schlae/tiny-turbo-286/TinyTurbo286Sch.pdf

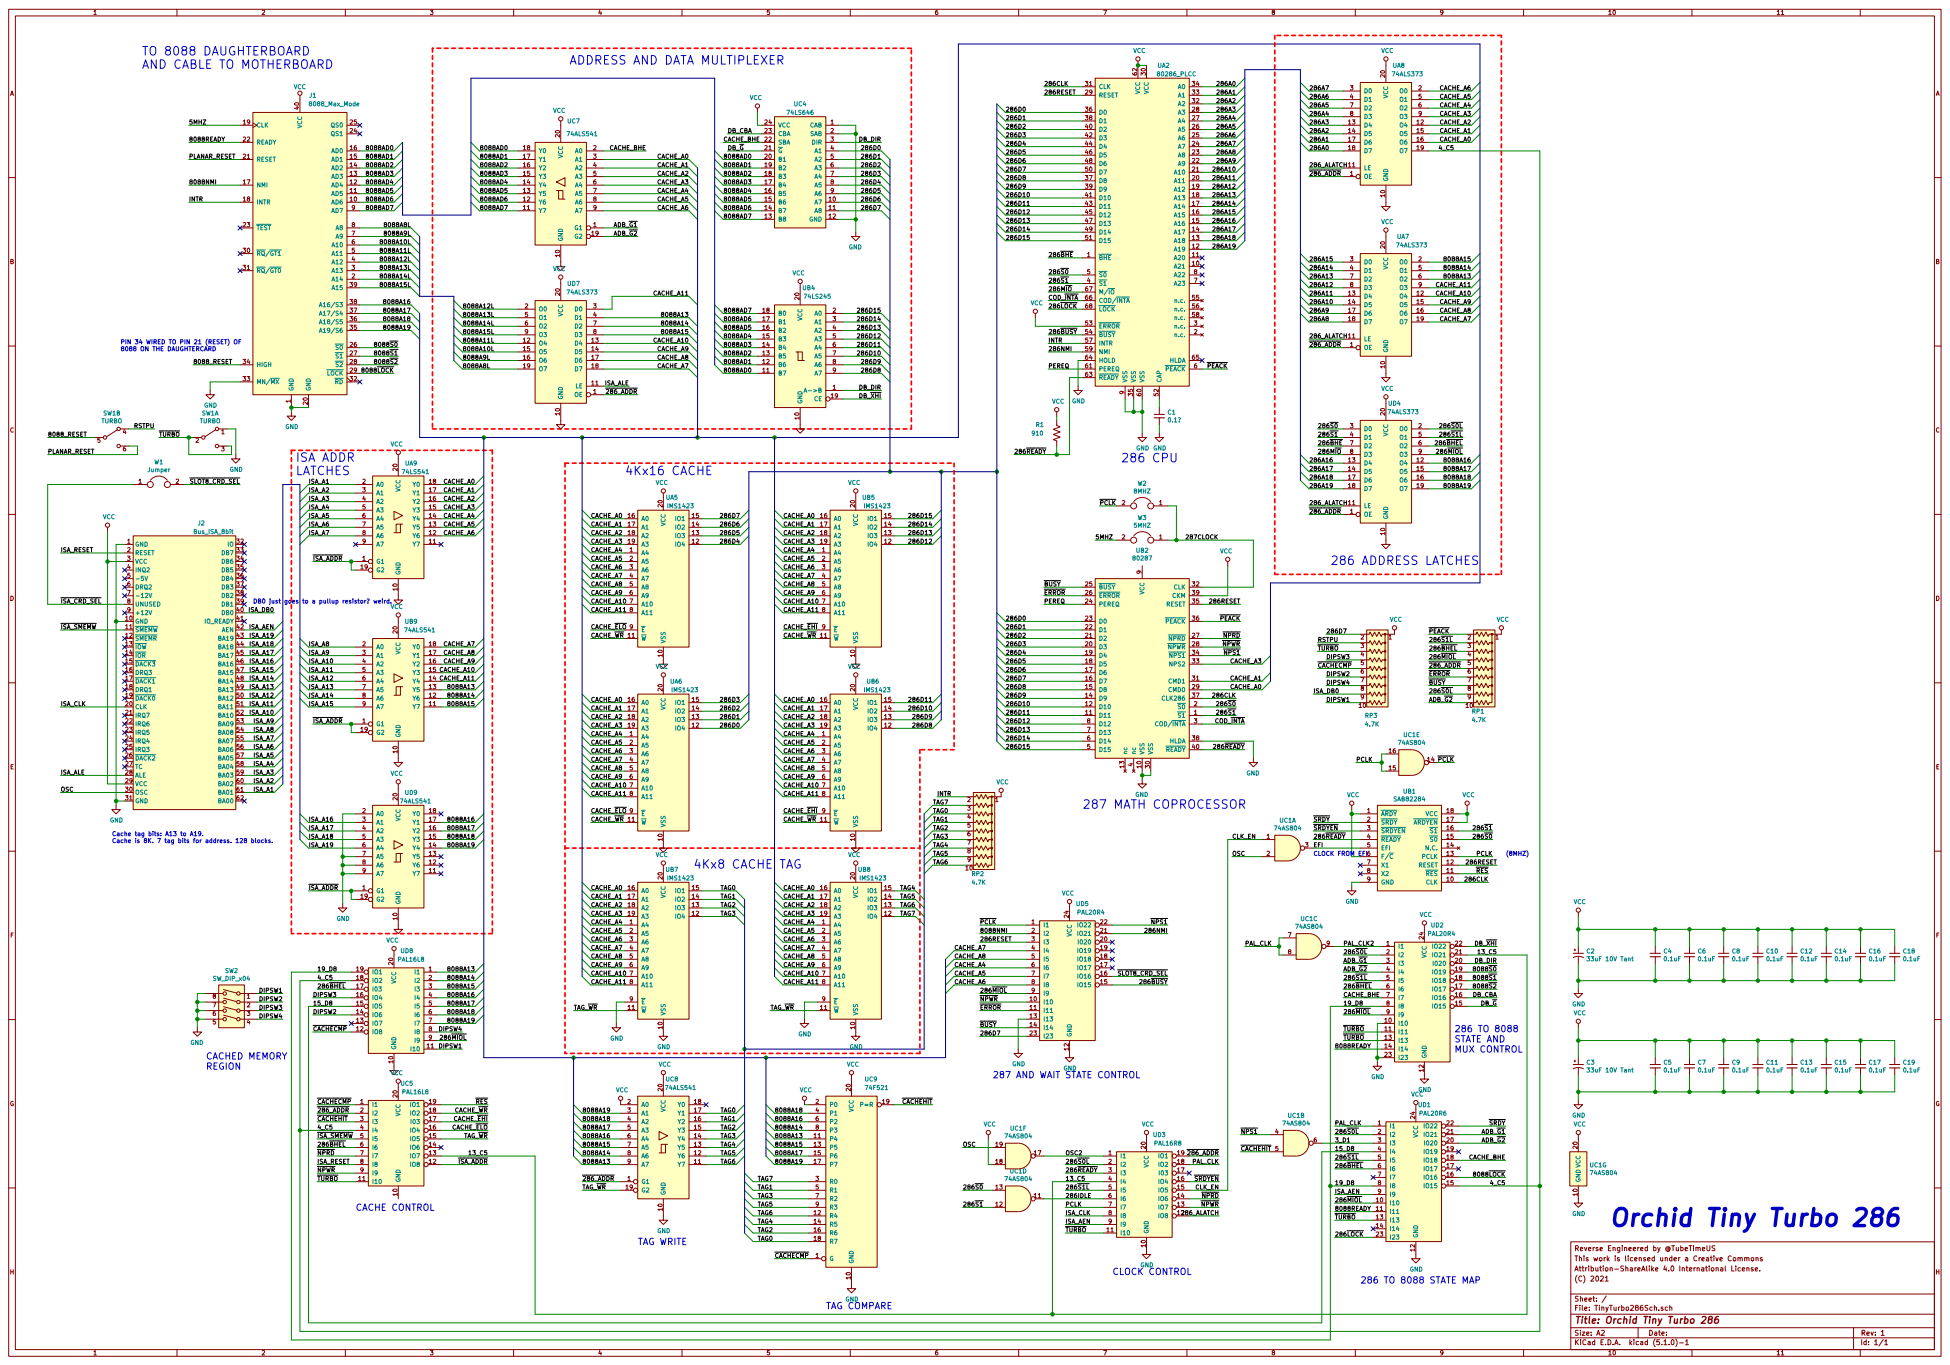
[picture p1: page 1]

TO 8088 DAUGHTERBOARD
AND CABLE TO MOTHERBOARD

ADDRESS AND DATA MULTIPLEXER

PIN 34 WIRED TO PIN 21 (RESET) OF
8088 ON THE DAUGHTERCARD

SLOT8_CRD_SEL
GND 1 GND 10 SMEMW 11 SMEMR 12
IOR 14 DACK3 15 DRQ3 16 DACK1 17 DRQ1 18 DACK0 19 RESET 2 CLK 20
IRQ3 25 DACK2 26 TC 27 ALE 28 VCC 29 VCC 3 OSC 30 GND 31

ISA_DB0 DB0 just goes to a pullup resistor? weird.
ISA_DB0

287 AND WAIT STATE CONTROL

File: TinyTurbo286Sch.sch Sheet: / (C) 2021 Attribution-ShareAlike 4.0 International License. This work is licensed under a Creative Commons Reverse Engineered by @TubeTimeUS

Id: 1/1 Title: Orchid Tiny Turbo 286
