schlae/tiny-turbo-286/TinyTurbo286Sch.sch

## KiCad design TinyTurbo286Sch.sch (2021-12-15)

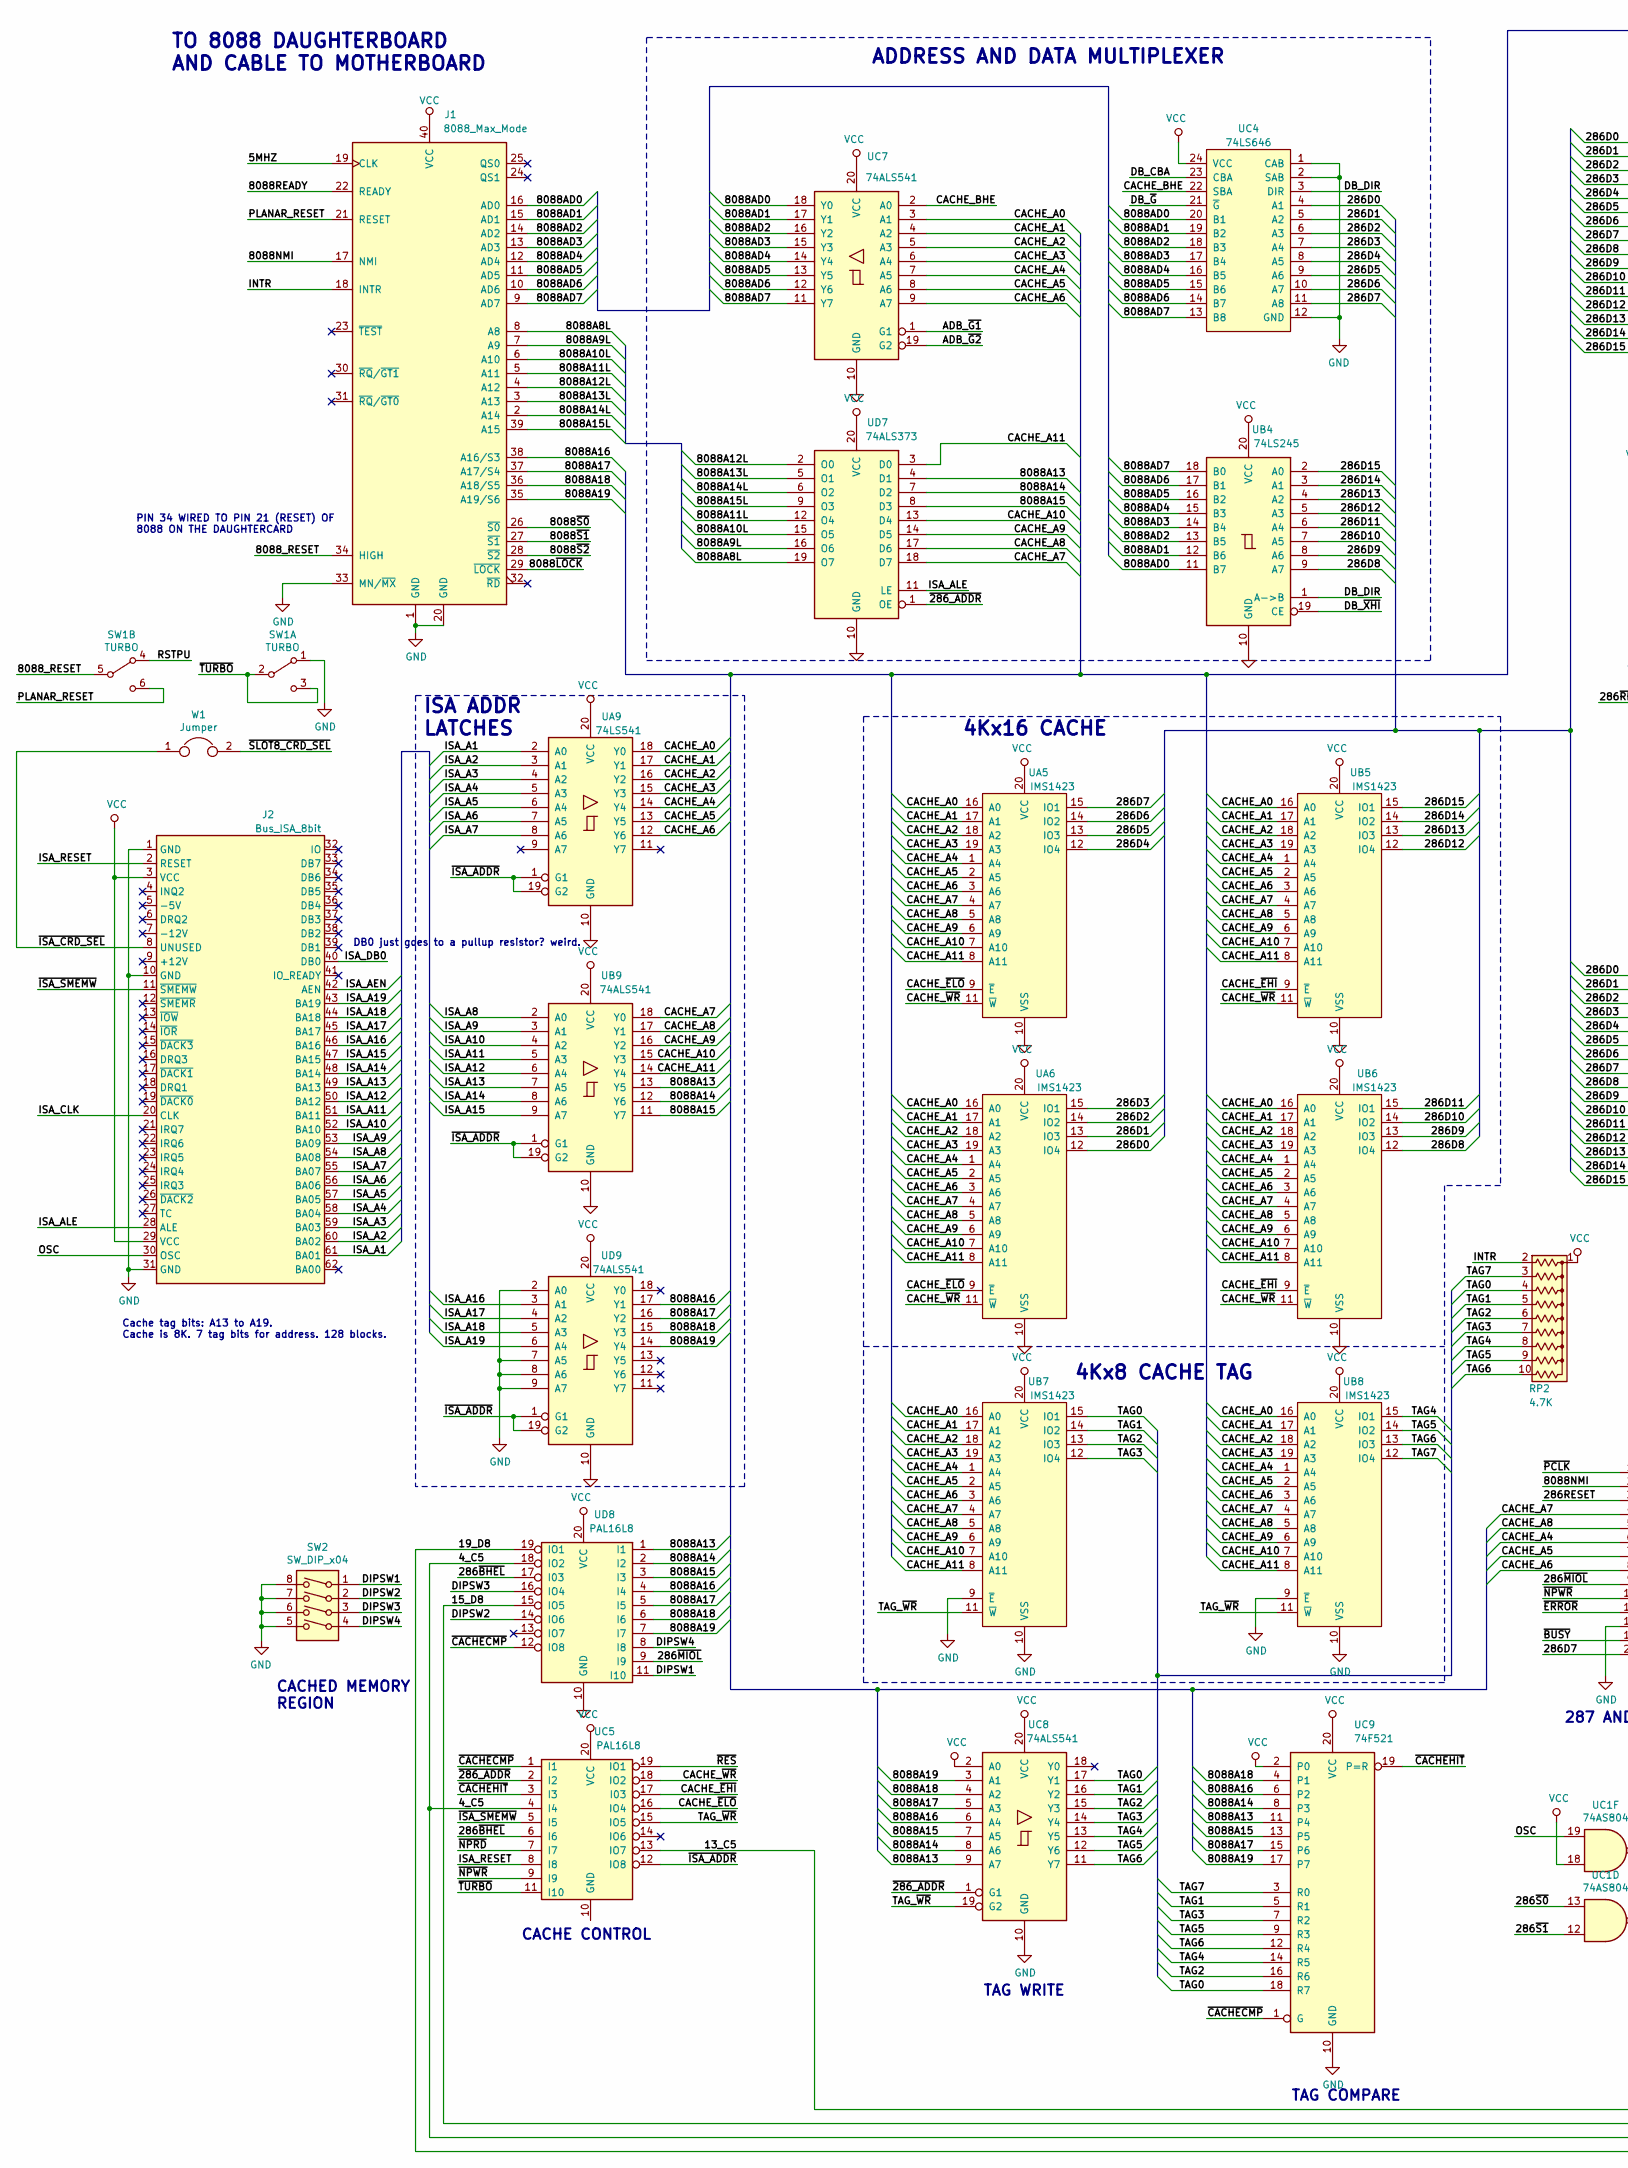
[picture p2: schematic TinyTurbo286Sch.sch, part in row 1, column 1]

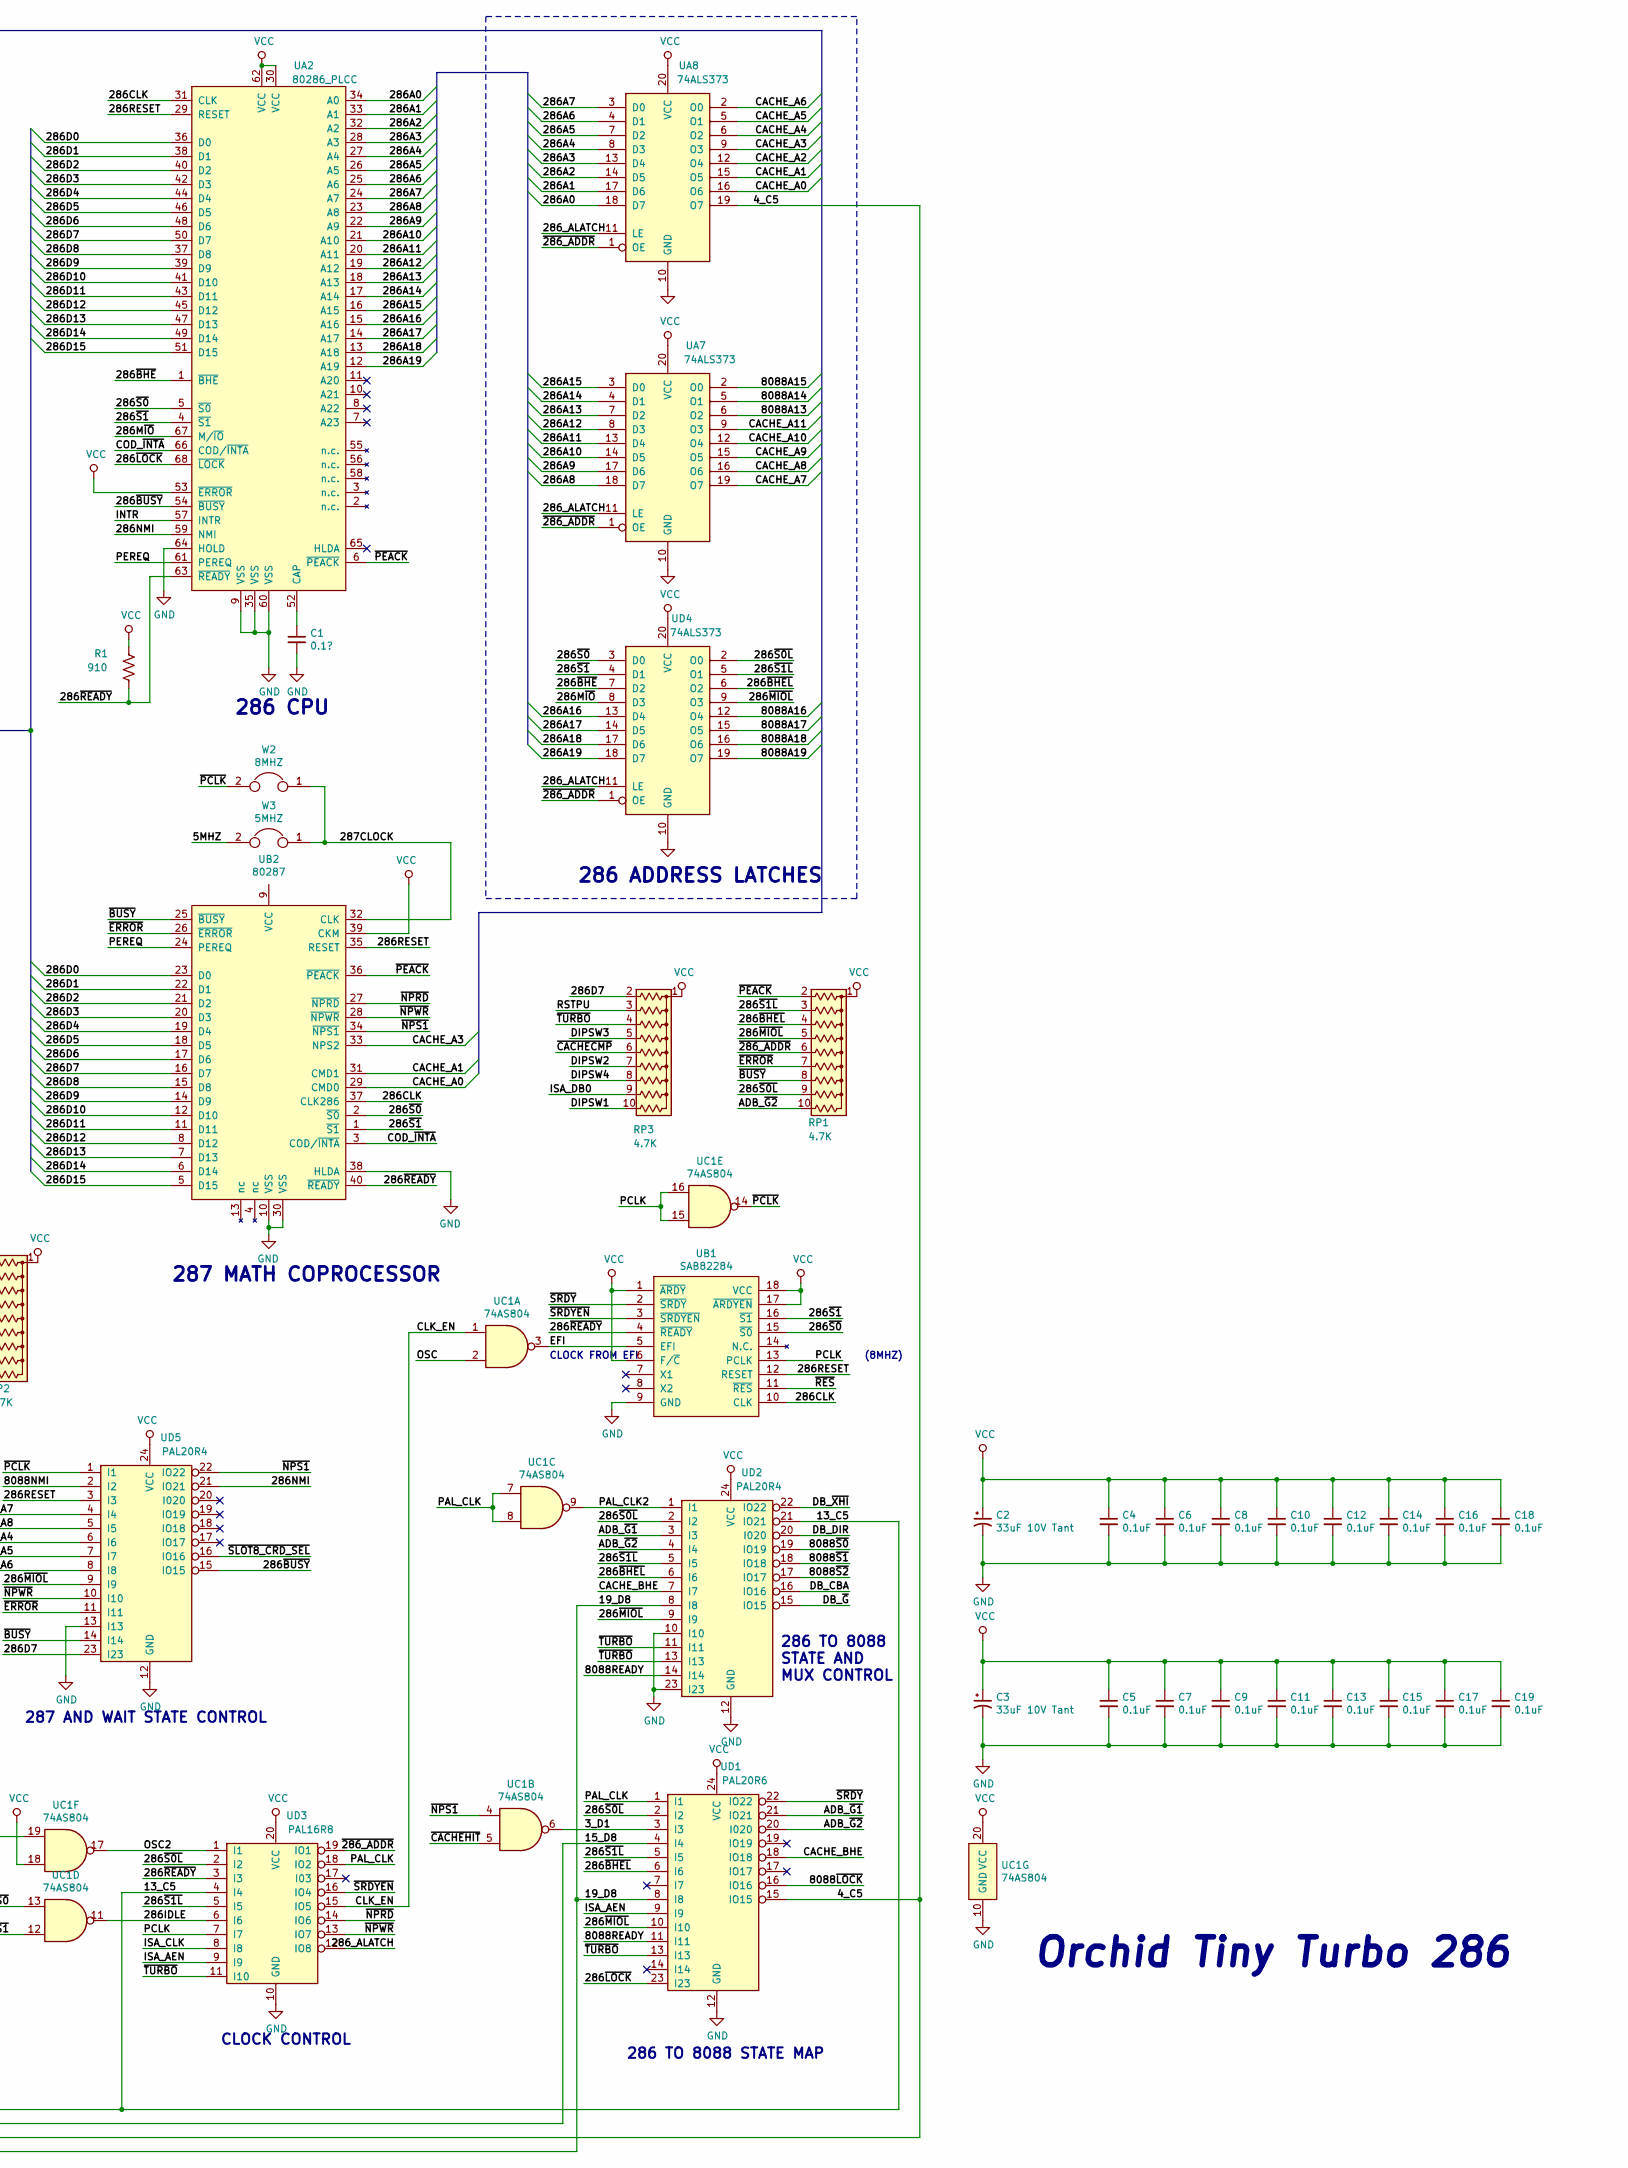
[picture p3: schematic TinyTurbo286Sch.sch, part in row 1, column 2]

Parts:
C1: 0.1?
C2, C3: 33uF 10V Tant
C4, C5, C6, C7, C8, C9, C10, C11, C12, C13, C14, C15, C16, C17, C18, C19: 0.1uF
J1: 8088_Max_Mode; DIP-40_W15.24mm
J2: Bus_ISA_8bit
R1: 910
RP1, RP2, RP3: 4.7K; R_Array_SIP10
SW1: TURBO
SW2: SW_DIP_x04
UA2: 80286_PLCC
UA5, UA6: IMS1423
UA7, UA8: 74ALS373
UA9: 74LS541
UB1: SAB82284
UB2: 80287
UB4: 74LS245
UB5, UB6, UB7, UB8: IMS1423
UB9: 74ALS541
UC1: 74AS804
UC4: 74LS646
UC5: PAL16L8
UC7, UC8: 74ALS541
UC9: 74F521
UD1: PAL20R6
UD2, UD5: PAL20R4
UD3: PAL16R8
UD4, UD7: 74ALS373
UD8: PAL16L8
UD9: 74ALS541
W1: Jumper
W2: 8MHZ
W3: 5MHZ

Connections:
3_D1: UC1.6, UD1.3 (I3)
4_C5: UA8.19 (O7), UC5.4 (I4), UD1.15 (IO15), UD8.18 (IO2)
5MHZ: J1.19 (CLK), W3.2
13_C5: UC5.13 (IO7), UD2.21 (IO21), UD3.4 (I4)
15_D8: UD1.4 (I4), UD8.15 (IO5)
19_D8: UD1.8 (I8), UD2.8 (I8), UD8.19 (IO1)
286A0: UA2.34 (A0), UA8.18 (D7)
286A1: UA2.33 (A1), UA8.17 (D6)
286A2: UA2.32 (A2), UA8.14 (D5)
286A3: UA2.28 (A3), UA8.13 (D4)
286A4: UA2.27 (A4), UA8.8 (D3)
286A5: UA2.26 (A5), UA8.7 (D2)
286A6: UA2.25 (A6), UA8.4 (D1)
286A7: UA2.24 (A7), UA8.3 (D0)
286A8: UA2.23 (A8), UA7.18 (D7)
286A9: UA2.22 (A9), UA7.17 (D6)
286A10: UA2.21 (A10), UA7.14 (D5)
286A11: UA2.20 (A11), UA7.13 (D4)
286A12: UA2.19 (A12), UA7.8 (D3)
286A13: UA2.18 (A13), UA7.7 (D2)
286A14: UA2.17 (A14), UA7.4 (D1)
286A15: UA2.16 (A15), UA7.3 (D0)
286A16: UA2.15 (A16), UD4.13 (D4)
286A17: UA2.14 (A17), UD4.14 (D5)
286A18: UA2.13 (A18), UD4.17 (D6)
286A19: UA2.12 (A19), UD4.18 (D7)
286CLK: UA2.31 (CLK), UB1.10 (CLK), UB2.37 (CLK286)
286D0: UA2.36 (D0), UA6.12 (IO4), UB2.23 (D0), UC4.4 (A1)
286D1: UA2.38 (D1), UA6.13 (IO3), UB2.22 (D1), UC4.5 (A2)
286D2: UA2.40 (D2), UA6.14 (IO2), UB2.21 (D2), UC4.6 (A3)
286D3: UA2.42 (D3), UA6.15 (IO1), UB2.20 (D3), UC4.7 (A4)
286D4: UA2.44 (D4), UA5.12 (IO4), UB2.19 (D4), UC4.8 (A5)
286D5: UA2.46 (D5), UA5.13 (IO3), UB2.18 (D5), UC4.9 (A6)
286D6: UA2.48 (D6), UA5.14 (IO2), UB2.17 (D6), UC4.10 (A7)
286D7: RP3.2 (R1), UA2.50 (D7), UA5.15 (IO1), UB2.16 (D7), UC4.11 (A8), UD5.23 (I23)
286D8: UA2.37 (D8), UB2.15 (D8), UB4.9 (A7), UB6.12 (IO4)
286D9: UA2.39 (D9), UB2.14 (D9), UB4.8 (A6), UB6.13 (IO3)
286D10: UA2.41 (D10), UB2.12 (D10), UB4.7 (A5), UB6.14 (IO2)
286D11: UA2.43 (D11), UB2.11 (D11), UB4.6 (A4), UB6.15 (IO1)
286D12: UA2.45 (D12), UB2.8 (D12), UB4.5 (A3), UB5.12 (IO4)
286D13: UA2.47 (D13), UB2.7 (D13), UB4.4 (A2), UB5.13 (IO3)
286D14: UA2.49 (D14), UB2.6 (D14), UB4.3 (A1), UB5.14 (IO2)
286D15: UA2.51 (D15), UB2.5 (D15), UB4.2 (A0), UB5.15 (IO1)
286IDLE: UC1.11, UD3.6 (I6)
286M~IO: UA2.67 (M/~IO), UD4.8 (D3)
286NMI: UA2.59 (NMI), UD5.21 (IO21)
286RESET: UA2.29 (RESET), UB1.12 (RESET), UB2.35 (RESET), UD5.3 (I3)
286_ALATCH: UA7.11 (LE), UA8.11 (LE), UD3.12 (IO8), UD4.11 (LE)
286~BHE: UA2.1 (~BHE), UD4.7 (D2)
286~BHEL: RP1.4 (R3), UC5.6 (I6), UD1.6 (I6), UD2.6 (I6), UD4.6 (O2), UD8.17 (I03)
286~BUSY: UA2.54 (~BUSY), UD5.15 (IO15)
286~LOCK: UA2.68 (~LOCK), UD1.23 (I23)
286~MIOL: RP1.5 (R4), UD1.10 (I10), UD2.9 (I9), UD4.9 (O3), UD5.9 (I9), UD8.9 (I9)
286~READY: R1.2, UA2.63 (~READY), UB1.4 (~READY), UB2.40 (~READY), UD3.3 (I3)
286~S0: UA2.5 (~S0), UB1.15 (~S0), UB2.2 (~S0), UC1.13, UD4.3 (D0)
286~S0L: RP1.9 (R8), UD1.2 (I2), UD2.2 (I2), UD3.2 (I2), UD4.2 (O0)
286~S1: UA2.4 (~S1), UB1.16 (~S1), UB2.1 (~S1), UC1.12, UD4.4 (D1)
286~S1L: RP1.3 (R2), UD1.5 (I5), UD2.5 (I5), UD3.5 (I5), UD4.5 (O1)
287CLOCK: UB2.32 (CLK), W2.1, W3.1
8088A8L: J1.8 (A8), UD7.19 (O7)
8088A9L: J1.7 (A9), UD7.16 (O6)
8088A10L: J1.6 (A10), UD7.15 (O5)
8088A11L: J1.5 (A11), UD7.12 (O4)
8088A12L: J1.4 (A12), UD7.2 (O0)
8088A13: UA7.6 (O2), UB9.13 (Y5), UC8.9 (A7), UC9.11 (P4), UD7.4 (D1), UD8.1 (I1)
8088A13L: J1.3 (A13), UD7.5 (O1)
8088A14: UA7.5 (O1), UB9.12 (Y6), UC8.8 (A6), UC9.8 (P3), UD7.7 (D2), UD8.2 (I2)
8088A14L: J1.2 (A14), UD7.6 (O2)
8088A15: UA7.2 (O0), UB9.11 (Y7), UC8.7 (A5), UC9.13 (P5), UD7.8 (D3), UD8.3 (I3)
8088A15L: J1.39 (A15), UD7.9 (O3)
8088A16: J1.38 (A16/S3), UC8.6 (A4), UC9.6 (P2), UD4.12 (O4), UD8.4 (I4), UD9.17 (Y1)
8088A17: J1.37 (A17/S4), UC8.5 (A3), UC9.15 (P6), UD4.15 (O5), UD8.5 (I5), UD9.16 (Y2)
8088A18: J1.36 (A18/S5), UC8.4 (A2), UC9.4 (P1), UD4.16 (O6), UD8.6 (I6), UD9.15 (Y3)
8088A19: J1.35 (A19/S6), UC8.3 (A1), UC9.17 (P7), UD4.19 (O7), UD8.7 (I7), UD9.14 (Y4)
8088AD0: J1.16 (AD0), UB4.11 (B7), UC4.20 (B1), UC7.18 (Y0)
8088AD1: J1.15 (AD1), UB4.12 (B6), UC4.19 (B2), UC7.17 (Y1)
8088AD2: J1.14 (AD2), UB4.13 (B5), UC4.18 (B3), UC7.16 (Y2)
8088AD3: J1.13 (AD3), UB4.14 (B4), UC4.17 (B4), UC7.15 (Y3)
8088AD4: J1.12 (AD4), UB4.15 (B3), UC4.16 (B5), UC7.14 (Y4)
8088AD5: J1.11 (AD5), UB4.16 (B2), UC4.15 (B6), UC7.13 (Y5)
8088AD6: J1.10 (AD6), UB4.17 (B1), UC4.14 (B7), UC7.12 (Y6)
8088AD7: J1.9 (AD7), UB4.18 (B0), UC4.13 (B8), UC7.11 (Y7)
8088NMI: J1.17 (NMI), UD5.2 (I2)
8088READY: J1.22 (READY), UD1.11 (I11), UD2.14 (I14)
8088_RESET: J1.34 (HIGH), SW1.5 (B)
8088~LOCK: J1.29 (~LOCK~), UD1.16 (IO16)
8088~S0: J1.26 (~S0~), UD2.19 (IO19)
8088~S1: J1.27 (~S1~), UD2.18 (IO18)
8088~S2: J1.28 (~S2~), UD2.17 (IO17)
ADB_~G1: UC7.1 (G1), UD1.21 (IO21), UD2.3 (I3)
ADB_~G2: RP1.10 (R9), UC7.19 (G2), UD1.20 (I020), UD2.4 (I4)
CACHE_A0: UA5.16 (A0), UA6.16 (A0), UA8.16 (O6), UA9.18 (Y0), UB2.29 (CMD0), UB5.16 (A0), UB6.16 (A0), UB7.16 (A0), UB8.16 (A0), UC7.3 (A1)
CACHE_A1: UA5.17 (A1), UA6.17 (A1), UA8.15 (O5), UA9.17 (Y1), UB2.31 (CMD1), UB5.17 (A1), UB6.17 (A1), UB7.17 (A1), UB8.17 (A1), UC7.4 (A2)
CACHE_A2: UA5.18 (A2), UA6.18 (A2), UA8.12 (O4), UA9.16 (Y2), UB5.18 (A2), UB6.18 (A2), UB7.18 (A2), UB8.18 (A2), UC7.5 (A3)
CACHE_A3: UA5.19 (A3), UA6.19 (A3), UA8.9 (O3), UA9.15 (Y3), UB2.33 (NPS2), UB5.19 (A3), UB6.19 (A3), UB7.19 (A3), UB8.19 (A3), UC7.6 (A4)
CACHE_A4: UA5.1 (A4), UA6.1 (A4), UA8.6 (O2), UA9.14 (Y4), UB5.1 (A4), UB6.1 (A4), UB7.1 (A4), UB8.1 (A4), UC7.7 (A5), UD5.6 (I6)
CACHE_A5: UA5.2 (A5), UA6.2 (A5), UA8.5 (O1), UA9.13 (Y5), UB5.2 (A5), UB6.2 (A5), UB7.2 (A5), UB8.2 (A5), UC7.8 (A6), UD5.7 (I7)
CACHE_A6: UA5.3 (A6), UA6.3 (A6), UA8.2 (O0), UA9.12 (Y6), UB5.3 (A6), UB6.3 (A6), UB7.3 (A6), UB8.3 (A6), UC7.9 (A7), UD5.8 (I8)
CACHE_A7: UA5.4 (A7), UA6.4 (A7), UA7.19 (O7), UB5.4 (A7), UB6.4 (A7), UB7.4 (A7), UB8.4 (A7), UB9.18 (Y0), UD5.4 (I4), UD7.18 (D7)
CACHE_A8: UA5.5 (A8), UA6.5 (A8), UA7.16 (O6), UB5.5 (A8), UB6.5 (A8), UB7.5 (A8), UB8.5 (A8), UB9.17 (Y1), UD5.5 (I5), UD7.17 (D6)
CACHE_A9: UA5.6 (A9), UA6.6 (A9), UA7.15 (O5), UB5.6 (A9), UB6.6 (A9), UB7.6 (A9), UB8.6 (A9), UB9.16 (Y2), UD7.14 (D5)
CACHE_A10: UA5.7 (A10), UA6.7 (A10), UA7.12 (O4), UB5.7 (A10), UB6.7 (A10), UB7.7 (A10), UB8.7 (A10), UB9.15 (Y3), UD7.13 (D4)
CACHE_A11: UA5.8 (A11), UA6.8 (A11), UA7.9 (O3), UB5.8 (A11), UB6.8 (A11), UB7.8 (A11), UB8.8 (A11), UB9.14 (Y4), UD7.3 (D0)
CACHE_BHE: UC4.22 (SBA), UC7.2 (A0), UD1.18 (IO18), UD2.7 (I7)
CACHE_~EHI: UB5.9 (~E), UB6.9 (~E), UC5.17 (I03)
CACHE_~ELO: UA5.9 (~E), UA6.9 (~E), UC5.16 (IO4)
CACHE_~WR: UA5.11 (~W), UA6.11 (~W), UB5.11 (~W), UB6.11 (~W), UC5.18 (IO2)
CLK_EN: UC1.1, UD3.15 (IO5)
COD_~INTA: UA2.66 (COD/~INTA), UB2.3 (COD/~INTA)
DB_CBA: UC4.23 (CBA), UD2.16 (IO16)
DB_DIR: UB4.1 (A->B), UC4.3 (DIR), UD2.20 (I020)
DB_~G: UC4.21 (~G), UD2.15 (IO15)
DB_~XHI: UB4.19 (CE), UD2.22 (IO22)
DIPSW1: RP3.10 (R9), SW2.1, UD8.11 (I10)
DIPSW2: RP3.7 (R6), SW2.2, UD8.14 (IO6)
DIPSW3: RP3.5 (R4), SW2.3, UD8.16 (IO4)
DIPSW4: RP3.8 (R7), SW2.4, UD8.8 (I8)
EFI: UB1.5 (EFI), UC1.3
GND: C1.2, C2.2, C3.2, C4.2, C5.2, C6.2, C7.2, C8.2, C9.2, C10.2, C11.2, C12.2, C13.2, C14.2, C15.2, C16.2, C17.2, C18.2, C19.2, J1.1 (GND), J1.20 (GND), J1.33 (MN/~MX~), J2.1 (GND), J2.10 (GND), J2.31 (GND), SW1.1 (A), SW2.5, SW2.6, SW2.7, SW2.8, UA2.9 (VSS), UA2.35 (VSS), UA2.60 (VSS), UA2.64 (HOLD), UA5.10 (VSS), UA6.10 (VSS), UA7.10 (GND), UA8.10 (GND), UA9.10 (GND), UB1.9 (GND), UB2.10 (VSS), UB2.30 (VSS), UB2.38 (HLDA), UB4.10 (GND), UB5.10 (VSS), UB6.10 (VSS), UB7.9 (~E), UB7.10 (VSS), UB8.9 (~E), UB8.10 (VSS), UB9.10 (GND), UC1.10 (GND), UC4.1 (CAB), UC4.2 (SAB), UC4.12 (GND), UC7.10 (GND), UC8.10 (GND), UC9.10 (GND), UD1.12 (GND), UD2.10 (I10), UD2.12 (GND), UD2.23 (I23), UD3.10 (GND), UD4.10 (GND), UD5.12 (GND), UD5.13 (I13), UD7.10 (GND), UD8.10 (GND), UD9.2 (A0), UD9.7 (A5), UD9.8 (A6), UD9.9 (A7), UD9.10 (GND)
INTR: J1.18 (INTR), RP2.2 (R1), UA2.57 (INTR)
ISA_A1: J2.61 (BA01), UA9.2 (A0)
ISA_A2: J2.60 (BA02), UA9.3 (A1)
ISA_A3: J2.59 (BA03), UA9.4 (A2)
ISA_A4: J2.58 (BA04), UA9.5 (A3)
ISA_A5: J2.57 (BA05), UA9.6 (A4)
ISA_A6: J2.56 (BA06), UA9.7 (A5)
ISA_A7: J2.55 (BA07), UA9.8 (A6)
ISA_A8: J2.54 (BA08), UB9.2 (A0)
ISA_A9: J2.53 (BA09), UB9.3 (A1)
ISA_A10: J2.52 (BA10), UB9.4 (A2)
ISA_A11: J2.51 (BA11), UB9.5 (A3)
ISA_A12: J2.50 (BA12), UB9.6 (A4)
ISA_A13: J2.49 (BA13), UB9.7 (A5)
ISA_A14: J2.48 (BA14), UB9.8 (A6)
ISA_A15: J2.47 (BA15), UB9.9 (A7)
ISA_A16: J2.46 (BA16), UD9.3 (A1)
ISA_A17: J2.45 (BA17), UD9.4 (A2)
ISA_A18: J2.44 (BA18), UD9.5 (A3)
ISA_A19: J2.43 (BA19), UD9.6 (A4)
ISA_AEN: J2.42 (AEN), UD1.9 (I9), UD3.9 (I9)
ISA_ALE: J2.28 (ALE), UD7.11 (LE)
ISA_CLK: J2.20 (CLK), UD3.8 (I8)
ISA_DB0: J2.40 (DB0), RP3.9 (R8)
ISA_RESET: J2.2 (RESET), UC5.8 (I8)
unnamed: C1.1, UA2.52 (CAP)
OSC: J2.30 (OSC), UC1.2, UC1.19
OSC2: UC1.17, UD3.1 (I1)
PAL_CLK: UC1.7, UC1.8, UD1.1 (I1), UD3.18 (IO2)
PAL_CLK2: UC1.9, UD2.1 (I1)
PCLK: UB1.13 (PCLK), UC1.15, UC1.16, UD3.7 (I7)
PEREQ: UA2.61 (PEREQ), UB2.24 (PEREQ)
PLANAR_RESET: J1.21 (RESET), SW1.6 (C)
RSTPU: RP3.3 (R2), SW1.4 (A)
TAG0: RP2.4 (R3), UB7.15 (IO1), UC8.17 (Y1), UC9.18 (R7)
TAG1: RP2.5 (R4), UB7.14 (IO2), UC8.16 (Y2), UC9.5 (R1)
TAG2: RP2.6 (R5), UB7.13 (IO3), UC8.15 (Y3), UC9.16 (R6)
TAG3: RP2.7 (R6), UB7.12 (IO4), UC8.14 (Y4), UC9.7 (R2)
TAG4: RP2.8 (R7), UB8.15 (IO1), UC8.13 (Y5), UC9.14 (R5)
TAG5: RP2.9 (R8), UB8.14 (IO2), UC8.12 (Y6), UC9.9 (R3)
TAG6: RP2.10 (R9), UB8.13 (IO3), UC8.11 (Y7), UC9.12 (R4)
TAG7: RP2.3 (R2), UB8.12 (IO4), UC9.3 (R0)
TAG_~WR: UB7.11 (~W), UB8.11 (~W), UC5.15 (IO5), UC8.19 (G2)
VCC: C2.1, C3.1, C4.1, C5.1, C6.1, C7.1, C8.1, C9.1, C10.1, C11.1, C12.1, C13.1, C14.1, C15.1, C16.1, C17.1, C18.1, C19.1, J1.40 (VCC), J2.3 (VCC), J2.29 (VCC), R1.1, RP1.1 (common), RP2.1 (common), RP3.1 (common), UA2.30 (VCC), UA2.53 (~ERROR), UA2.62 (VCC), UA5.20 (VCC), UA6.20 (VCC), UA7.20 (VCC), UA8.20 (VCC), UA9.20 (VCC), UB1.1 (~ARDY), UB1.6 (F/~C), UB1.17 (~ARDYEN), UB1.18 (VCC), UB2.39 (CKM), UB4.20 (VCC), UB5.20 (VCC), UB6.20 (VCC), UB7.20 (VCC), UB8.20 (VCC), UB9.20 (VCC), UC1.18, UC1.20 (VCC), UC4.24 (VCC), UC5.20 (VCC), UC7.20 (VCC), UC8.2 (A0), UC8.20 (VCC), UC9.2 (P0), UC9.20 (VCC), UD1.24 (VCC), UD2.24 (VCC), UD3.20 (VCC), UD4.20 (VCC), UD5.24 (VCC), UD7.20 (VCC), UD8.20 (VCC), UD9.20 (VCC)
~286_ADDR: RP1.6 (R5), UA7.1 (OE), UA8.1 (OE), UC5.2 (I2), UC8.1 (G1), UD3.19 (IO1), UD4.1 (OE), UD7.1 (OE)
~BUSY: RP1.8 (R7), UB2.25 (~BUSY), UD5.14 (I14)
~CACHECMP: RP3.6 (R5), UC5.1 (I1), UC9.1 (G), UD8.12 (IO8)
~CACHEHIT: UC1.5, UC5.3 (I3), UC9.19 (P=R)
~ERROR: RP1.7 (R6), UB2.26 (~ERROR), UD5.11 (I11)
~ISA_ADDR: UA9.1 (G1), UA9.19 (G2), UB9.1 (G1), UB9.19 (G2), UC5.12 (IO8), UD9.1 (G1), UD9.19 (G2)
~ISA_CRD_SEL: J2.8 (UNUSED), W1.1
~ISA_SMEMW: J2.11 (~SMEMW), UC5.5 (I5)
~NPRD: UB2.27 (~NPRD), UC5.7 (I7), UD3.14 (IO6)
~NPS1: UB2.34 (~NPS1), UC1.4, UD5.22 (IO22)
~NPWR: UB2.28 (~NPWR), UC5.9 (I9), UD3.13 (IO7), UD5.10 (I10)
~PCLK: UC1.14, UD5.1 (I1), W2.2
~PEACK: RP1.2 (R1), UA2.6 (~PEACK), UB2.36 (~PEACK)
~RES: UB1.11 (~RES), UC5.19 (IO1)
~SLOT8_CRD_SEL: UD5.16 (IO16), W1.2
~SRDY: UB1.2 (~SRDY), UD1.22 (IO22)
~SRDYEN: UB1.3 (~SRDYEN), UD3.16 (IO4)
~TURBO: RP3.4 (R3), SW1.2 (B), SW1.3 (C), UC5.11 (I10), UD1.13 (I13), UD2.11 (I11), UD2.13 (I13), UD3.11 (I10)

Notes on the sheet:
Cache tag bits: A13 to A19. Cache is 8K. 7 tag bits for address. 128 blocks.
PIN 34 WIRED TO PIN 21 (RESET) OF 8088 ON THE DAUGHTERCARD
CLOCK FROM EFI
DB0 just goes to a pullup resistor? weird.
CACHE CONTROL
287 AND WAIT STATE CONTROL
CLOCK CONTROL
286 TO 8088 STATE AND MUX CONTROL
286 TO 8088 STATE MAP
CACHED MEMORY REGION
TAG WRITE
TAG COMPARE
287 MATH COPROCESSOR
286 CPU
286 ADDRESS LATCHES
(8MHZ)
4Kx8 CACHE TAG
4Kx16 CACHE
ADDRESS AND DATA MULTIPLEXER
ISA ADDR LATCHES
TO 8088 DAUGHTERBOARD AND CABLE TO MOTHERBOARD
Orchid Tiny Turbo 286
